pfs26/Encaminament-LoRa/(threads)

Thread 6 (2025-03-14):

Pointers vs References

pfs26, 2025-03-14:
Utilitzar referències en lloc d'apuntadors als llocs on sigui possible i necessari (asseguren que no són `nullptr`, més fàcil de seguir, etc.)
https://stackoverflow.com/questions/7058339/when-should-i-use-pointers-instead-of-references-in-api-design

Closed 2025-06-04.
