pfs26/Encaminament-LoRa/hardware/PCB/PCB.kicad_pcb

## KiCad design hardware/PCB/PCB.kicad_pcb (2025-03-25, last stored version)

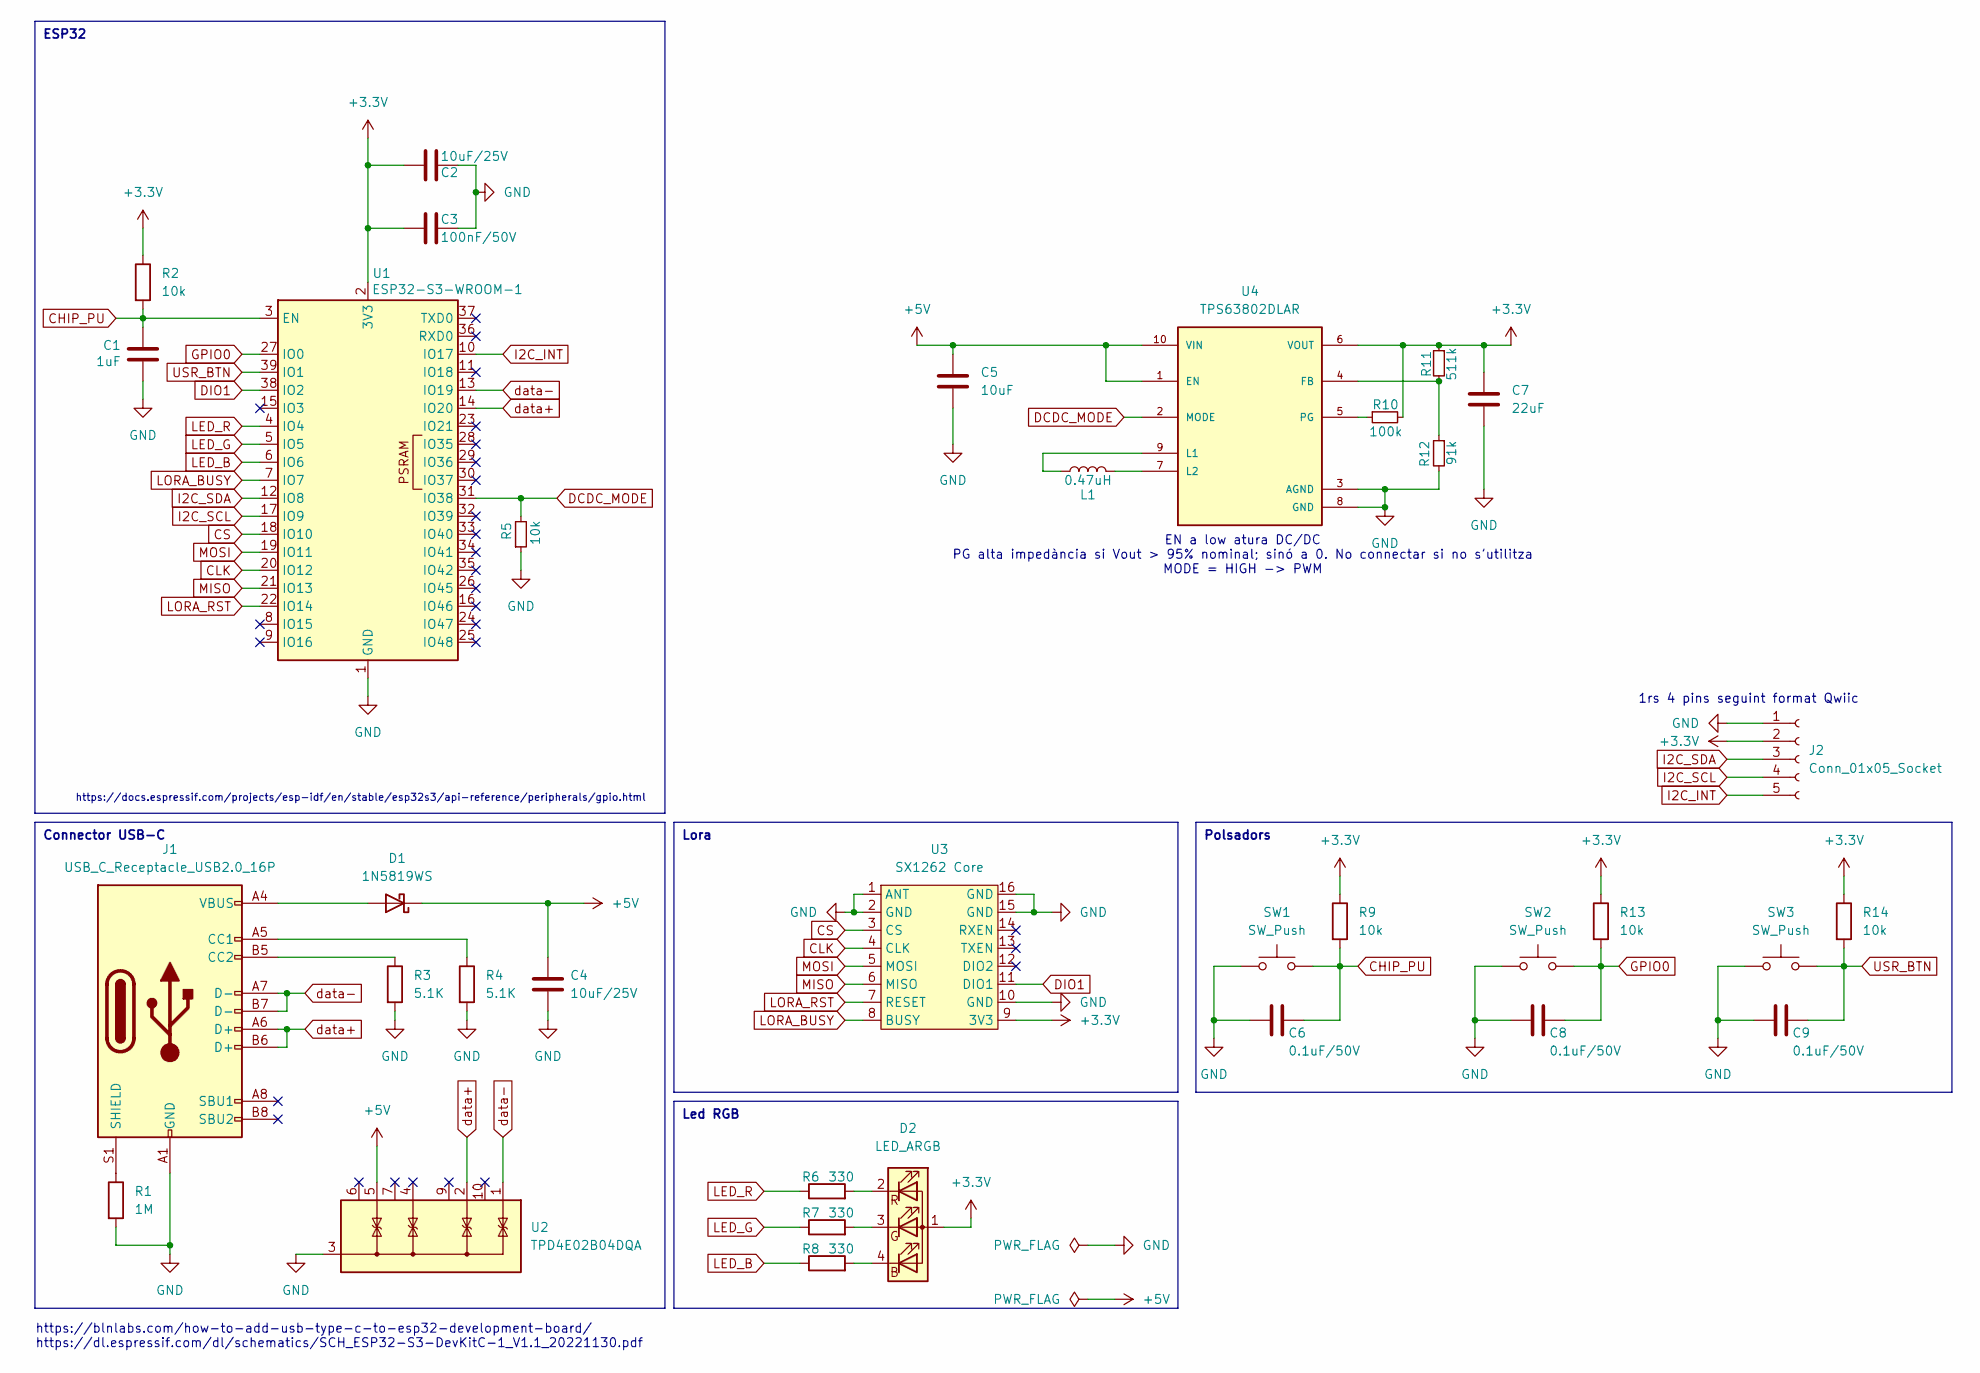
[picture p3: schematic PCB.kicad_sch, Node LoRa basat en SX1262 i ESP32]

Parts:
C1: 1uF; C_0805_2012Metric_Pad1.18x1.45mm_HandSolder
C2, C4: 10uF/25V; C_0805_2012Metric_Pad1.18x1.45mm_HandSolder
C3: 100nF/50V; C_0805_2012Metric_Pad1.18x1.45mm_HandSolder
C5: 10uF; C_0805_2012Metric_Pad1.18x1.45mm_HandSolder
C6, C8, C9: 0.1uF/50V; C_0805_2012Metric_Pad1.18x1.45mm_HandSolder
C7: 22uF; C_0805_2012Metric_Pad1.18x1.45mm_HandSolder
D1: 1N5819WS; D_SOD-323
D2: LED_ARGB; LED_RGB_Lumex_SML-LXT0805SIUGUBW
J1: USB_C_Receptacle_USB2.0_16P; USB_C_Receptacle_GCT_USB4085
J2: Conn_01x05_Socket; JST_PH_S5B-PH-K_1x05_P2.00mm_Horizontal
L1: 0.47uH; R_0805_2012Metric_Pad1.20x1.40mm_HandSolder
R1: 1M; R_0805_2012Metric_Pad1.20x1.40mm_HandSolder
R2, R5, R9, R13, R14: 10k; R_0805_2012Metric_Pad1.20x1.40mm_HandSolder
R3, R4: 5.1K; R_0805_2012Metric_Pad1.20x1.40mm_HandSolder
R6, R7, R8: 330; R_0805_2012Metric_Pad1.20x1.40mm_HandSolder
R10: 100k; R_0805_2012Metric_Pad1.20x1.40mm_HandSolder
R11: 511k; R_0805_2012Metric_Pad1.20x1.40mm_HandSolder
R12: 91k; R_0805_2012Metric_Pad1.20x1.40mm_HandSolder
SW1, SW2, SW3: SW_Push; SW_SPST_B3U-1000P
U1: ESP32-S3-WROOM-1
U2: TPD4E02B04DQA; USON-10_2.5x1.0mm_P0.5mm
U3: SX1262 Core
U4: TPS63802DLAR; VREG_TPS63802DLAR; PARTREV B

Connections:
+3.3V: C2.2, C3.2, C7.1, D2.1 (A), J2.2, R2.1, R9.1, R10.2, R11.1, R13.1, R14.1, U1.2 (3V3), U3.9 (3V3), U4.6 (VOUT)
+5V: C4.1, C5.1, D1.1 (K), U2.5 (IO4), U4.1 (EN), U4.10 (VIN)
CHIP_PU: C1.1, C6.1, R2.2, R9.2, SW1.2, U1.3 (EN)
CLK: U1.20 (IO12), U3.4 (CLK)
CS: U1.18 (IO10), U3.3 (CS)
DCDC_MODE: R5.2, U1.31 (IO38), U4.2 (MODE)
DIO1: U1.38 (IO2), U3.11 (DIO1)
GND: C1.2, C2.1, C3.1, C4.2, C5.2, C6.2, C7.2, C8.2, C9.2, J1.A1 (GND), J1.A12 (GND), J1.B1 (GND), J1.B12 (GND), J2.1, R1.2, R3.2, R4.2, R5.1, R12.2, SW1.1, SW2.1, SW3.1, U1.1 (GND), U1.40 (GND), U1.41 (GND), U2.3 (G), U2.8 (G), U3.1 (ANT), U3.2 (GND), U3.10 (GND), U3.15 (GND), U3.16 (GND), U4.3 (AGND), U4.8 (GND)
GPIO0: C8.1, R13.2, SW2.2, U1.27 (IO0)
I2C_INT: J2.5, U1.10 (IO17)
I2C_SCL: J2.4, U1.17 (IO9)
I2C_SDA: J2.3, U1.12 (IO8)
LED_B: R8.1, U1.6 (IO6)
LED_G: R7.1, U1.5 (IO5)
LED_R: R6.1, U1.4 (IO4)
LORA_BUSY: U1.7 (IO7), U3.8 (BUSY)
LORA_RST: U1.22 (IO14), U3.7 (RESET)
MISO: U1.21 (IO13), U3.6 (MISO)
MOSI: U1.19 (IO11), U3.5 (MOSI)
unnamed: D1.2 (A), J1.A4 (VBUS), J1.A9 (VBUS), J1.B4 (VBUS), J1.B9 (VBUS)
unnamed: D2.4 (BK), R8.2
unnamed: D2.3 (GK), R7.2
unnamed: D2.2 (RK), R6.2
unnamed: J1.A5 (CC1), R4.1
unnamed: J1.B5 (CC2), R3.1
unnamed: J1.S1 (SHIELD), R1.1
unnamed: R11.2, R12.1, U4.4 (FB)
unnamed: L1.1, U4.9 (L1)
unnamed: L1.2, U4.7 (L2)
unnamed: R10.1, U4.5 (PG)
USR_BTN: C9.1, R14.2, SW3.2, U1.39 (IO1)
data+: J1.A6 (D+), J1.B6 (D+), U1.14 (IO20), U2.2 (IO2)
data-: J1.A7 (D-), J1.B7 (D-), U1.13 (IO19), U2.1 (IO1)

Notes on the sheet:
Polsadors
Connector USB-C
ESP32
Led RGB
Lora
1rs 4 pins seguint format Qwiic
https://docs.espressif.com/projects/esp-idf/en/stable/esp32s3/api-reference/peripherals/gpio.html
https://blnlabs.com/how-to-add-usb-type-c-to-esp32-development-board/ https://dl.espressif.com/dl/schematics/SCH_ESP32-S3-DevKitC-1_V1.1_20221130.pdf
EN a low atura DC/DC PG alta impedància si Vout > 95% nominal; sinó a 0. No connectar si no s'utilitza MODE = HIGH -> PWM

Board: 2 copper layers, 35 parts (0 on the bottom side), 33 nets, no tracks yet.
