pfs26/Encaminament-LoRa/(commit log)

2025-02-19 Mòdul gestor de configuració (memòria no volàtil) inicial
2025-02-21 Mòdul webpage utilitzant scheduler per comprovacions de DNS, evitant bloquejar fil principal. Funcionament verificat
2025-02-26 DEBUG: Canviar llibreria lora a RadioLib per millor compatibilitat amb SX1262
2025-02-26 DEV: Afegir fitxer utils i moure funcions de config a utils. Reflectar-ho a fitxers existents
2025-02-26 ERR: Error en interrupcions (WDT timeout). Fent backtrace sembla que prové de , que pot suposar un cost en temps gran
    [lora.cpp, lora.h]
2025-02-26 DEBUG: Afegir opcions de backtrace per crash d'esp32 a platformio
2025-02-27 DEBUG: Arreglar error interrupcions, utilitzant scheduler amb funció de gestió d'interrupcions. Closes #1
    [lora.cpp, lora.h]
2025-02-27 DEBUG: Afegir informació estat memòria HEAP en cleanup de tasques per veure com afecta
2025-02-28 DEV: Afegir mètode per obtenir TimeOnAir a partir d'un nombre de bytes a LoRa
2025-03-01 DEV: Afegir funcions print paquet lora per debug
2025-03-03 DEV: Classe de buffer circular per permetre cues de mida variable a les diferents capes (utilitzat de moment a capa MAC; en un futur a capa transport)
2025-03-03 DEV: Refer capa MAC per permetre enviaments d'ACK. FSM refeta de 0. Mètode callback executat per capa LoRa refet per gestionar recepcions i esdeveniments a FSM
2025-03-04 DEBUG: Buffer circular hauria de ser de uint16_t i no de 8
2025-03-04 DEV: Mètode per enviar ACK a MAC. Error detecció ACK i en filtrat de recepció de missatges. Millores de format de debug
    [mac.cpp, mac.h]
2025-03-04 DEBUG: Ringbuffer també ha de tenir uint8_t a header i resta d'implementació
2025-03-04 DEBUG: Detalls a prints de debug per millor format
2025-03-04 DEBUG: Millors pinrts a modul scheduler
2025-03-04 DEV: Afegir linies debug a MAC. Proves TX RX. Bug detectat: en generar MAC TX ERR no es reben més interrupcions de LoRa
    [mac.cpp, mac.h]
2025-03-04 DEBUG: Error on guardar flags d'interrupcions a capa LoRa. Si se¡n generaven dues seguides abans que es comprovessin es perdia la primera
    [lora.cpp]
2025-03-05 DEV: Millors macros de debug
2025-03-05 DEBUG: Canvis traces debugs a altres fitxers
2025-03-05 DEBUG: Si print dins de scheduler reset per timer de WDT. Eliminar
    [scheduler.cpp, utils.h]
2025-03-05 DEV: Afegir edge case de max length
2025-03-05 DEV: Primera refactorització capa MAC. Eliminar atribut length de PDU (ja que tampoc existeix com a tal a la transmissió). Utilitza '\0' com a final en tots els casos. Càlcul de CRC refet per utilitz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
2025-03-05 DEV: Refactor de headers MAC per incloure FLAGS, facilitant ACK i millores futures
2025-03-05 DEV: Incloure datalength a header de MAC. No es pot utilitzar \0 -> Fallaria si capa superior té un byte 0x00 entre mig de les dades
2025-03-05 DEBUG: Afegir canvi mida de printLora a size_t per evitar problemes si mai mida és major a 255
    [lora.cpp, lora.h]
2025-03-05 DEV: Afegir mètode per forçar inici de recepció de LoRa. Evita que es quedi en mode standby quan hi ha un MAC tx err
2025-03-05 DEV: Refer capa MAC amb la nova capa LoRa. Utilitzar noves estructures de headers i format. Millora en gestió de FSM i en gestió d'errors de TX. S'ha provat únicament un TX i un RX i no ha donat prob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
    [mac.cpp, mac.h]
2025-03-06 DEV: Millores a traces de debug per mostrar colors més intuitius
2025-03-06 Refactor: canvis en funcions de FSM i introducció de funcions auxiliars per evitar repetició
2025-03-06 feat: millores a macros debug per aliniar text
2025-03-06 Debug: arreglar error lectura dades MAC des de capa superior. Closes #3
    [mac.cpp, utils.h]
2025-03-07 Debug: evitar callbacks de LoRa a MAC després de deinicialitzar LoRa
2025-03-07 feat: afegir valors estadístics a capa MAC (errorsTX, errorsCRC, recepcions, enviaments correctes)
    [mac.cpp]
2025-03-07 chore: reorganitzar fitxers no de capa, però d'utilitat
2025-03-07 refactor: canviar declaració MAC PDU per utilitzar directament mac_data_t i no redefinir un array de nou
2025-03-07 dev: implementació inicial taula de rutes a NVS i la seva gestió
2025-03-07 dev: implementació mòdul routing table. Encarregat de gestionar taula de rutes estàtica
2025-03-08 feat: evitar update de routing table si l'estat d'aquesta ja era igual al canvi (evitar escriptura flash)
2025-03-08 fix: arreglar error si taula rutes mai creada generava inicialització fallida
    [routing_table.cpp]
2025-03-08 chore: tasques de documentació, todo, etc
2025-03-08 dev: implementació linked list per cues MAC. Linked list permet mides de cues dinàmiques sense necessitat de blocs contigus (evitat rellocs)
2025-03-09 feat: inici implementació FSM per permetre buffers de transmissió, amb 2 prioritats per ACK i data. S'observa com potser és millor utilitzar ACKs explícits, per evitar barrejar tasques de capes (rout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
2025-03-10 feat: afegir mètode per obtenir mida de LinkedFIFO
2025-03-10 feat: implementació buffers amb ACK, evitant esperar ACK en enviar-ne. Verificacions de nova FSM, i simplificació
2025-03-10 debug: en proves amb canal ocupat fictici, BEB no inicia recepció lora; arreglat forçant recepció lora enc as de chan busy
    [mac.cpp]
2025-03-11 doc: comentaris a scheduler en iniciar tasca de neteja
2025-03-11 feat: tenir en compte regulacions de duty cycle en enviar per LoRa. Potser no és el més lògic aplicar-ho si s'ha d'enviar un ACK; veure què es pot fer (potser tenir en compte el temps transcorregut a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
2025-03-12 feat: implementació mòdul mac_buffer per gestionar-hi les cues de recepció i transmissió
2025-03-12 feat: afegir mètodes per obtenir mides de buffers de MAC
2025-03-12 refactor: canviar comentaris codi MAC, eliminar funcions no utilitzades. Codis de test cues
2025-03-12 feat: mètode per obtenir missatges pendents de ser rebuts a capa MAC. Es dona per acabada les cues. Closes #4
2025-03-12 refactor: afegir header comú de lora per compartir-lo amb modul lorawan
2025-03-12 feat: primera iteració mòdul LoRaWAN. Falta verificar en un gateway. Hi pot haver conflictes entre LoRaWAN i LoRa pelat -> mirar de deshabilitat interrupcions generades per sx1262 quan s'interactua a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
2025-03-13 refactor: definir tipus d'adreça de node a fitxer comú, per utilitzar-lo a múltiples capes. Definir macro per validar adreça
2025-03-13 refactor: utilitzar sizeof(mac_id_t) per generar id aleatori, i no dependre de definició manual
2025-03-14 feat: implementar mètode de recepció de lorawan; estructura per guardar-ne informació; documentació inline de lorawan. Closes #5
2025-03-14 debug: mala inicialització de nou modul lora a mac
2025-03-14 feat: implementar callbacks amb ID de frame enviats a capa MAC, per permetre seguiment d'estat de frames a capes superiors. Veure #7
2025-03-14 debug: error en validació d'adreça de node correcte a macro
    [lora_common.h, node_address.h]
2025-03-16 feat: implementar notificacions d'esdeveniments de tx amb identificadors a routing
2025-03-17 debug: comentaris de todo i possibles revisions que potser cal fer en un futur. Propagació d'identificadors de frames no tenen perquè ser mac_id_t, evitant dependència i obrint possibilitat a impleme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
2025-03-17 feat: implementació capa transport utilitzant propagació d'ID de MAC, enviar segments amb o sense reconeixement, rebre segments i enviar ACK si sol·licitat
2025-03-19 feat: desenvolupament inicial esquemàtic hardware, i layout PCB
    [PCB.kicad_pcb, PCB.kicad_sch]
2025-03-21 feat: implementar potència de transmissió adaptativa en funció de reintents
2025-03-21 debug: error en enviar per lorawan si hi ha error. No canviava a mode de LoRaRAW
    [lorawan.cpp]
2025-03-21 docu: comentaris bàsics i canvis de defines a lora
2025-03-21 refactor: canviar nom carpetes
    [PCB.kicad_pcb, PCB.kicad_sch]
2025-03-24 feat: més versions de PCB i layouts inicials
    [PCB.kicad_pcb, PCB.kicad_sch]
2025-03-25 feat: afegir comprovació adreça invàlida si s'especifica adreça de gateway (adreça 'virtual')
2025-03-25 refactor: canviar nom d'adreça de gateway per mantenir coherència amb altres adreces
2025-03-25 feat: versió PCB nova; prova lorawan amb routing
2025-03-26 debug: limitar potència màxima per evitar crash d'esp per falta de corrent
    [lora_common.h]
2025-03-26 debug: error en canvia de mode LoRaWAN a LoRaRAW mantenia configuració de radio de WAN. Closes #13
    [lora.cpp, lorawan.cpp, lorawan.h]
2025-03-26 debug: canviar missatge de debug per ser més informatiu
2025-03-26 test: codi exemple i verificació encaminament cap a LoRaWAN per node amb rol de gateway
2025-03-26 feat: implementar configuració de callbacks depenent de port per millor gestió a capa aplicació. Closes #11. Gestió de múltiples inicialitzacions i deinicialitzacions a capa aplicació (que hauria de 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
2025-03-26 debug: error en obtenir el port a notificar onSend -> s'utilitzava el port de l'ACK rebut i no el del missatge que s'havia enviat
    [transport.cpp]
2025-03-27 feat: implementar guardar nonces a NVS per complir amb especificació v1.1 de LoRaWAN. Closes #14
2025-03-28 debug: aplicar logica preprocessador per si no es defineix duty cycle. De moment no acaba d'estar ben implementat restriccions de duty cycle
2025-03-29 debug: error en obtenir nonces de nvs a lorawan
    [lorawan.cpp]
2025-03-29 refactor: canviar estructura de mac on es guarden paquets per no guardar IDs ficticis de LW
2025-04-02 test: provar test enviament de TTN cap a un node de la xarxa que NO sigui el de rol gateway (enviament directe)
2025-04-04 debug: error en comprovar si un port ja s'estava utilitzant a transport
    [sleep.cpp, transport.cpp]
2025-04-04 feat: implementar aplicació sleep com a mòdul únic, permetent compatibilitat amb altres aplicacions i més facilitat d'ús. Exposar mètodes per permetre guardar dades abans de dormir
2025-04-07 debug: error a transport en definir array de handlers per ports
    [transport.cpp]
2025-04-08 debug: si un node és iniciador de sleep sync no s'hauria de modificar el sue cicle de sleep
2025-04-08 debug: canvi en prints de debug
2025-04-08 debug: a sleep s'executava abans que enviament de SYNC
2025-04-08 debug: permetre rebre ACK i dades a la vegada a transport
2025-04-08 debug: routing no hauria de notificar a transport (per generar ACK) en enviar per lorawan si no es realitza la transmissió
2025-04-08 debug: transport no hauria de generar notificacions de recepció si es rep un ack
2025-04-08 debug: random a capa mac no inclou valor màxim. Paràmetre temps de guardia a sleep
2025-04-16 memoria: detall LoRa (mida màxima i preàmbul) + revisar abstracció LoRa + accés medi documentar estructura de les trames i diagrama
2025-04-17 debug: mac constant d'ack hauria de ser 3 i no 2 (temps recepció RX + temps TX rx + temps recepció TX)
2025-04-18 memoria: afegir dos diagrames de situacions de capa mac
2025-04-25 feat: ruta a través de gateway, oferint molta més flexibilitat (per exemple dues xarxes unides a través d'un gateway). Closes #17
2025-04-25 feat: potència de transmissió d'ACK de capa MAC depèn del nombre de reintents realitzats per la transmissió del frame rebut. Closes #16
2025-04-25 feat: transport notificacions de TX fallida a capa app. Notificacions de TX únicament per TCP i missatges que esperen ACK! Si no, no. Representa que no interessa saber-ne l'estat ni seguiment
2025-04-25 feat: afegir notificacions de txerror. Permetre notificacions de tx i txerror també per UDP. Metadades ara globals i no únicament per TCP
2025-04-25 debug: routing hauria de comprovar si ruta següent salt es per gateway i actuar, i no pas actuar directament si es gateway a partir d'adreça de destí. Això en encaminar, en enviar per capa superior j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
2025-04-27 memoria: explicar com dispositiu amb capacitats lorawan processarà segmetns tot i no estar dirigits a ell, per poder generar ACK
2025-05-04 debug: error en sleep si timeout, avançant delta temps cada cop
    [sleep.cpp]
2025-05-05 feat: millorar tout ack, aplicant únicament el temps de transmetre les dades d'un ACK i no múltiples
2025-05-05 feat: implementar càlcul temps delta de forma dinàmica a partir de nodes anteriors. Calcular despres de rebre ja que s'ha fet calcul de nou de nodes i pot afectar temps sleep
2025-05-06 exemples: test bàsci lora millorat
2025-05-06 exemples: test bàsci lora millorat, millora verificació max length
2025-05-06 exemples: refactor dels exemples per adaptar-se a implementació final de protocol
2025-05-06 debug: error en ppm de clock rtc. Per proves sense rtc extern, millor utilitzar 8000. No es considerava error de clock del dispositiu anterior
    [sleep.h]
2025-05-06 debug: error en ppm, de forma experimental s'ha vist un error de -20 segons per 15 minuts, aproximadament unes 25000ppm
    [sleep.h]
2025-05-08 sleep: abans de canvis en error clock
    [sleep.cpp, sleep.h]
2025-05-15 diagrama 2 millorat. Comentaris diagrama dos i altres opcions
2025-05-19 memoria: diagrames millorats indicant one sta gateway
2025-05-21 debug: error en rebre lora d'altra gent amb mides inferiors a mínima i mal format de trames
    [mac.cpp, main.cpp, routing.cpp, transport.cpp]
2025-05-21 debug: eliminar correció clock sleep. Valors per defecte sleep i unitats uint64t correctes en float
    [sleep.cpp, sleep.h]
2025-05-22 memoria: revisió text escrit anteriorment de SYNC. Inici temps tolerància (delta)
2025-05-22 memoria: explicat limit de dades i fragmentacio
2025-05-24 memoria: canviar estructura situacions no ideals. Afegirs resultats errors en diferents temps de funcionament
2025-05-24 memoria: no sé ni que he fet
2025-05-25 feat: callback sleep proporciona la mida de les dades que ha de copiar
2025-05-25 feat: sleep amb fsm. Neteja de codi
2025-05-25 memoria: revisió i utilització app. Fer que numero dispositius sigui definició i no variable
2025-05-28 memoria: ref system time esp32
2025-05-28 eliminar codi innecessari. Eliminar PCB no feta. Eliminar README per defecte. Modificar main.cpp per ser igual a exemple
    [PCB.kicad_pcb, PCB.kicad_sch]
2025-05-28 refactor: eliminar codi comentar de lora.cpp
2025-05-28 eliminar opcions de config innecessaries
2025-05-28 refactor: eliminar resultats que no aporten res, i no cal entregar.
2025-05-29 test 1min tout. Eliminar bytes invàlids afegits per picocom de logs
2025-05-29 analisis amb millor format. Arreglar fitxer log listener
2025-05-31 memoria: afegir conclusions i revisar-les
2025-06-03 memoria: correcions i millora conclusio
